muaz8172/hydro/docs/pdf/04_System_Diagram_and_Flowchart.pdf

1 · ARCHITECTURE

# Block diagram

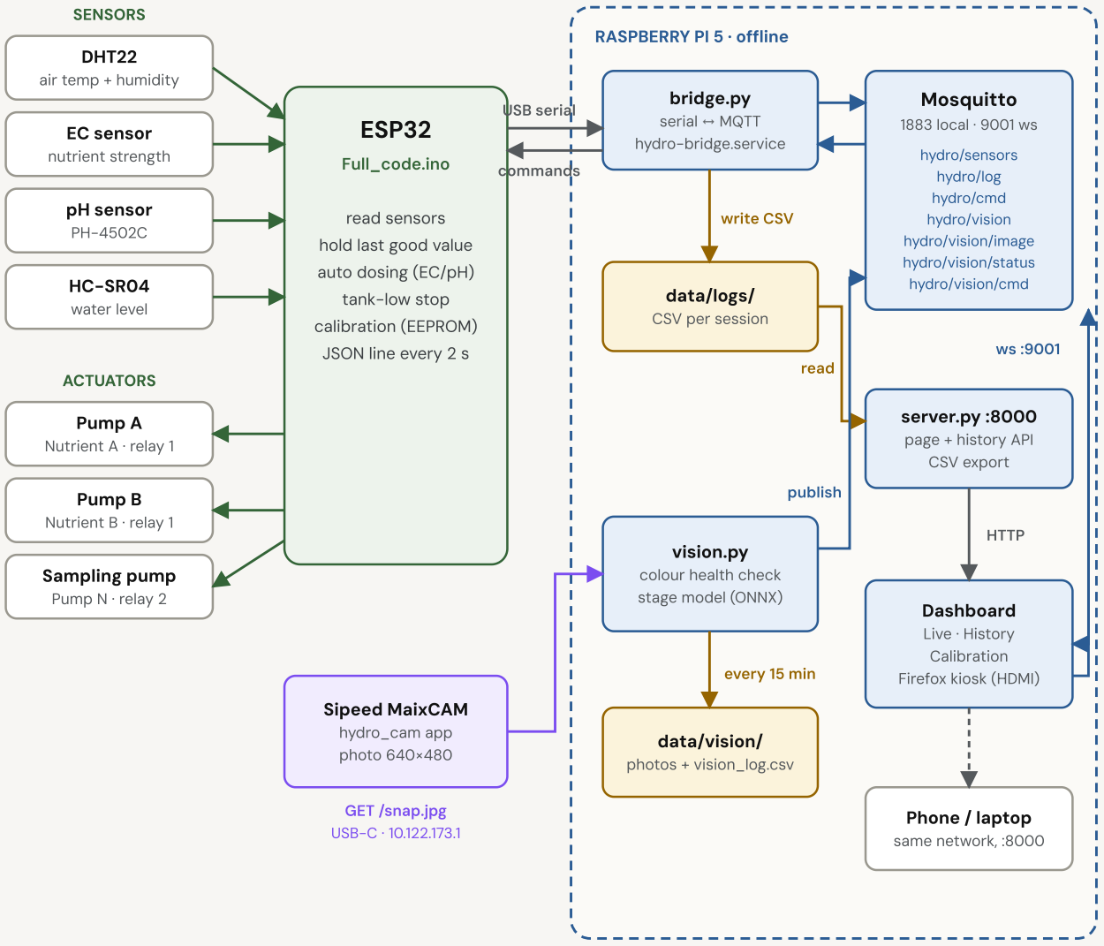
[picture p11: figure]
SENSORS; DHT22; air temp + humidity; EC sensor; nutrient strength; pH sensor; water level; ACTUATORS; Pump A; Nutrient A · relay 1; Pump B; Nutrient B · relay 1; Sampling pump; Pump N · relay 2; ESP32; Full_code.ino; read sensors; hold last good value; auto dosing (EC/pH); tank-low stop; calibration (EEPROM); JSON line every 2 s; Sipeed MaixCAM; hydro_cam app; photo 640×480; RASPBERRY PI 5 · offline; bridge.py; serial ↔ MQTT; hydro-bridge.service; Mosquitto; 1883 local · 9001 ws; hydro/sensors; hydro/log; hydro/cmd; hydro/vision; hydro/vision/image; hydro/vision/status; hydro/vision/cmd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

sensor / relay wiring | USB serial (JSON every 2 s) | MQTT | files on the Pi

camera (USB-C network)

In short: the ESP32 is the only part that touches the hardware and it keeps dosing and protecting the pumps even if the Pi is

off. The Pi adds memory (CSV logs), eyes (camera + AI) and a screen (dashboard). All links are local: a USB cable to the ESP32,

USB-C to the camera, and MQTT on the Pi itself.

HYDR O · INN OVAT I O N 202 6 · D O C U M ENT 4 O F 5

# System Diagram & Flowchart

How data moves from the sensors through the ESP32, the USB cable and the MQTT broker

to the logs, the camera AI and the dashboard, and how the firmware decides when to run

the pumps.

04

Hydro · 04 System Diagram & Flowchart | 1

2 · MESSAGING

# MQTT topics

Mosquitto runs on the Pi. Programs on the Pi use port 1883 (localhost only); the dashboard

in the browser uses the WebSocket listener on port 9001.

Topic | Published by | Read by | Content
hydro/sensors | bridge.py | Dashboard | One JSON reading every 2 s (+ log_id , row )
hydro/log | bridge.py | Dashboard | ESP32 text messages (calibration replies, warnings)
hydro/cmd | Dashboard, mosquitto_pub | bridge.py → ESP32 | Commands: status , enterec , ph7 , pumpauto , …
hydro/vision | vision.py | Dashboard | Health, canopy, yellowing, stage, confidence, size (JSON)
hydro/vision/image | vision.py | Dashboard | Latest photo as JPEG bytes (retained)
hydro/vision/status | vision.py | Dashboard | online or offline: <reason>
hydro/vision/cmd | Dashboard | vision.py | snap = save a photo now

### Path of one sensor reading

### Path of a command (e.g. calibration)

# Services on the Pi (start-up order)

Service | Starts when | Runs
mosquitto | Boot | MQTT broker (1883 local, 9001 websocket)
hydro-bridge | ESP32 plugged in (udev → /dev/esp32 ); stops when unplugged | backend/bridge.py
hydro-vision | Boot | backend/vision.py , photo every 10 s
hydro-dashboard | Boot | backend/server.py on port 8000
hydro-kiosk (user) | Desktop log-in | Firefox full screen on the HDMI monitor,
| | screen never blanks

Everything runs offline: the dashboard's libraries ( mqtt.js , uPlot) and fonts are stored in frontend/vendor/ . If

the browser cannot reach port 9001, the camera photo still updates over HTTP from frontend/live/ .

Hydro · 04 System Diagram & Flowchart | MQTT topics and data paths

# ESP32 firmware logic

### Main loop

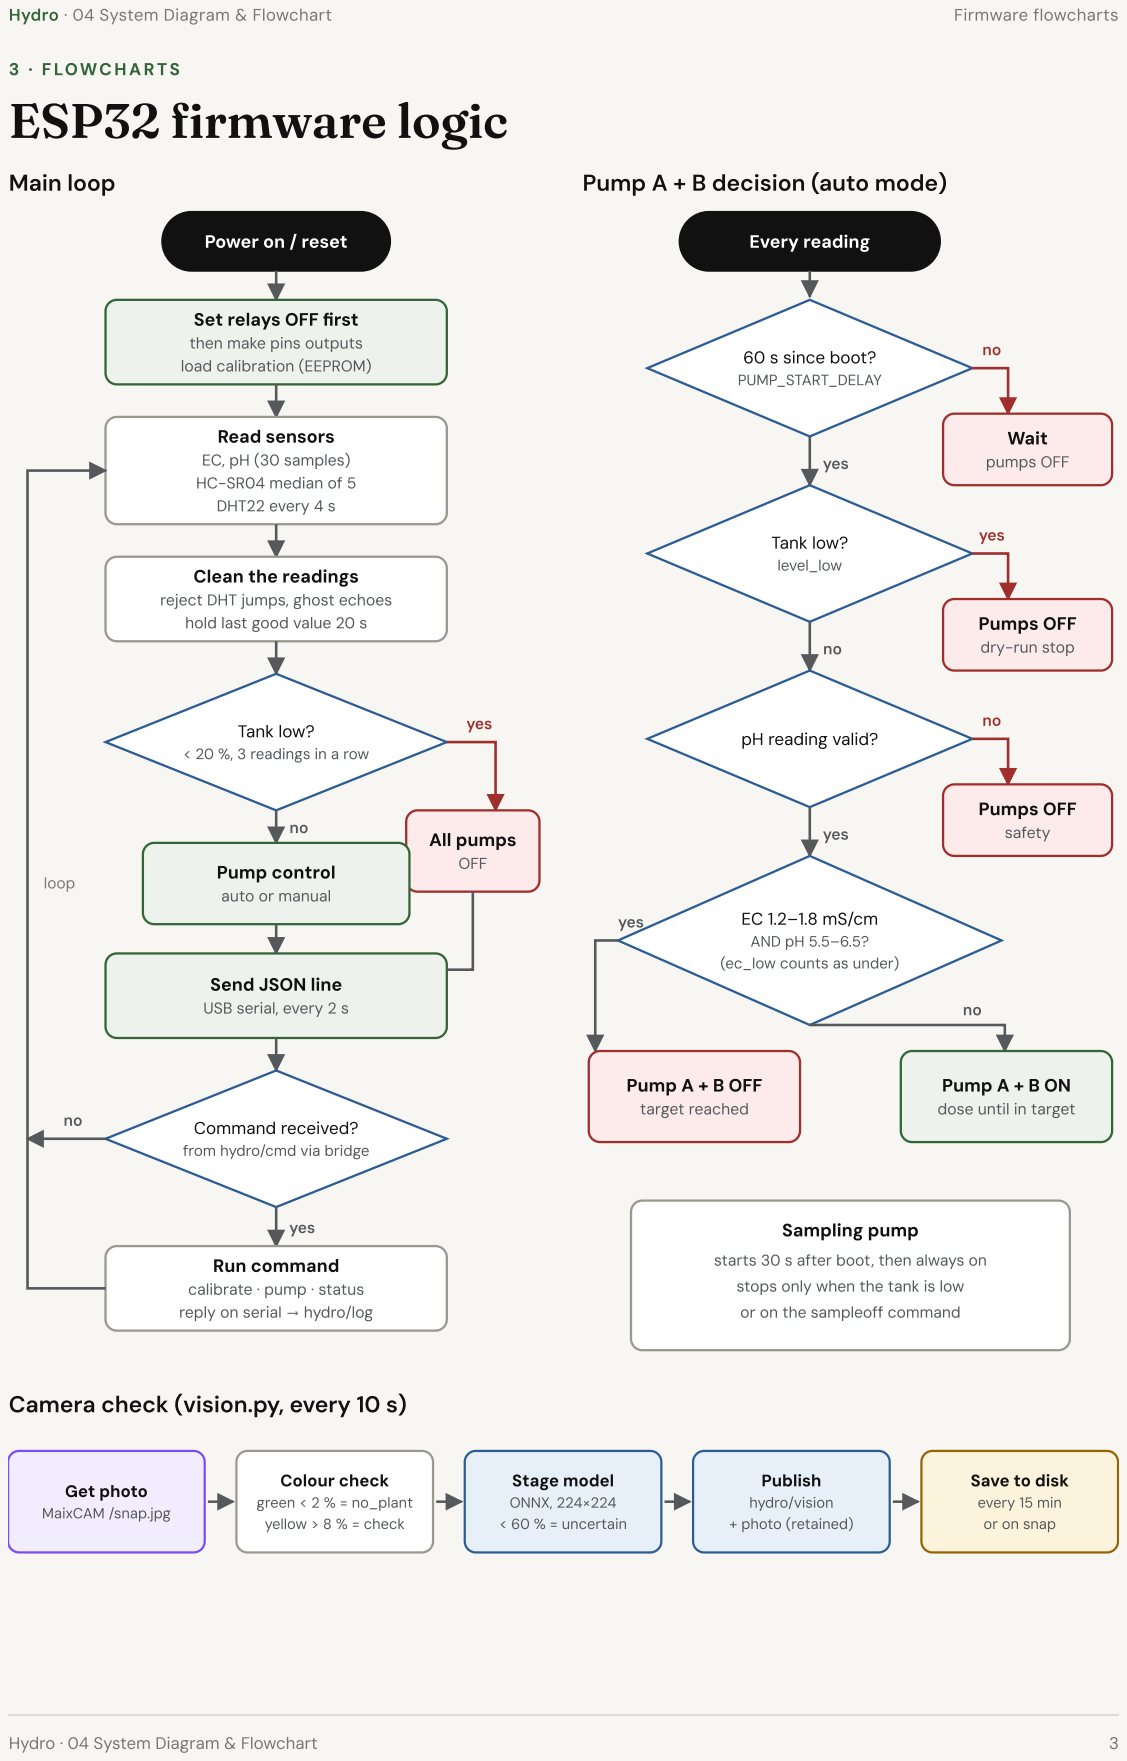
[picture p12: page 3]
3 · FLOWCHARTS; Read sensors; DHT22 every 4 s; Tank low?; yes; All pumps; OFF; Pump control; Command received?; Run command; loop; Every reading; 60 s since boot?; PUMP_START_DELAY; Wait; pumps OFF; level_low; Pumps OFF; dry-run stop; safety; Pump A + B OFF; target reached; Pump A + B ON; Sampling pump; Get photo; Colour check; green < 2 % = no_plant; yellow > 8 % = check; Stage model; ONNX, 224×224; < 60 % = uncertain; Publish; hydro/vision; + photo (retained); every 15 min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

Pump A + B decision (auto mode)

Power on / reset

Set relays OFF first

then make pins outputs

load calibration (EEPROM)

EC, pH (30 samples)

HC-SR04 median of 5

Clean the readings

reject DHT jumps, ghost echoes

hold last good value 20 s

pH reading valid?

< 20 %, 3 readings in a row

auto or manual

AND pH 5.5–6.5?
(ec_low counts as under)

Send JSON line

USB serial, every 2 s

dose until in target

from hydro/cmd via bridge

starts 30 s after boot, then always on

stops only when the tank is low

calibrate · pump · status
reply on serial → hydro/log

or on the sampleoff command

Camera check (vision.py, every 10 s)

Save to disk

MaixCAM /snap.jpg

or on snap
