muaz8172/hydro/backend/models/stage_training.png

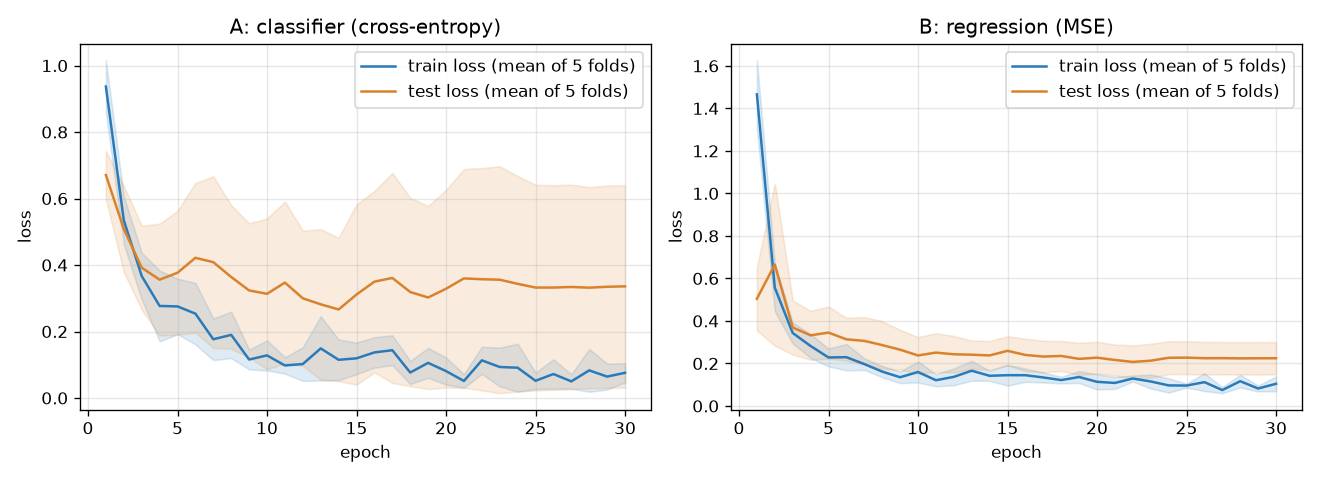
backend/models/stage_training.png
