muaz8172/hydro/dataset/lettuce_224/matured/matured_004.jpg

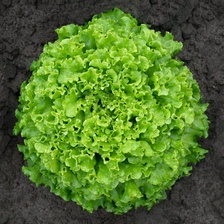
dataset/lettuce_224/matured/matured_004.jpg
