muaz8172/hydro/dataset/lettuce_224/matured/matured_005.jpg

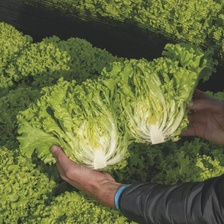
dataset/lettuce_224/matured/matured_005.jpg
