muaz8172/hydro/dataset/lettuce_224/matured/matured_009.jpg

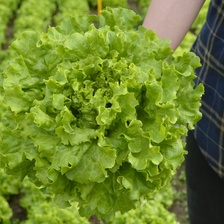
dataset/lettuce_224/matured/matured_009.jpg
