muaz8172/hydro/dataset/lettuce_224/matured/matured_011.jpg

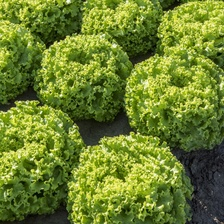
dataset/lettuce_224/matured/matured_011.jpg
