muaz8172/hydro/dataset/lettuce_224/matured/matured_013.jpg

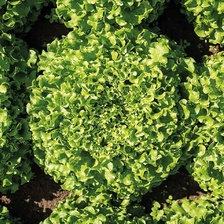
dataset/lettuce_224/matured/matured_013.jpg
