muaz8172/hydro/dataset/lettuce_224/matured/matured_015.jpg

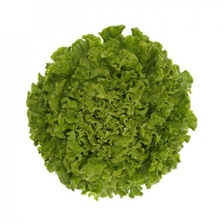
dataset/lettuce_224/matured/matured_015.jpg
