muaz8172/hydro/dataset/lettuce_224/matured/matured_016.jpg

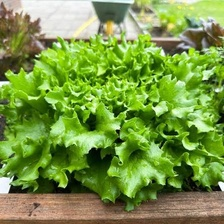
dataset/lettuce_224/matured/matured_016.jpg
