muaz8172/hydro/dataset/lettuce_224/matured/matured_023.jpg

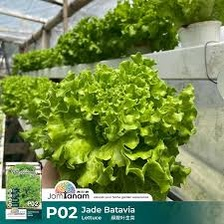
dataset/lettuce_224/matured/matured_023.jpg
