muaz8172/hydro/dataset/lettuce_224/matured/matured_024.jpg

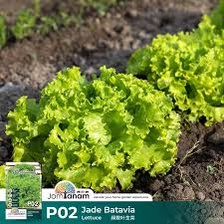
dataset/lettuce_224/matured/matured_024.jpg
