muaz8172/hydro/dataset/lettuce_224/matured/matured_025.jpg

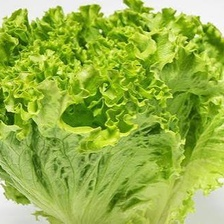
dataset/lettuce_224/matured/matured_025.jpg
