muaz8172/hydro/dataset/lettuce_224/matured/matured_026.jpg

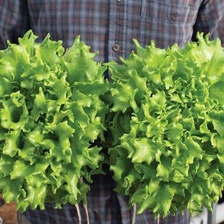
dataset/lettuce_224/matured/matured_026.jpg
