muaz8172/hydro/dataset/lettuce_224/matured/matured_027.jpg

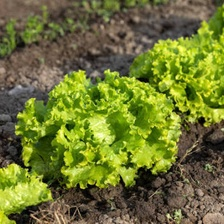
dataset/lettuce_224/matured/matured_027.jpg
