muaz8172/hydro/dataset/lettuce_224/seedling/seedling_005.jpg

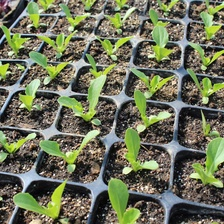
dataset/lettuce_224/seedling/seedling_005.jpg
