muaz8172/hydro/dataset/lettuce_224/seedling/seedling_006.jpg

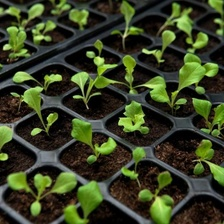
dataset/lettuce_224/seedling/seedling_006.jpg
