muaz8172/hydro/dataset/lettuce_224/seedling/seedling_009.jpg

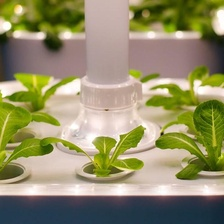
dataset/lettuce_224/seedling/seedling_009.jpg
