muaz8172/hydro/dataset/lettuce_224/seedling/seedling_015.jpg

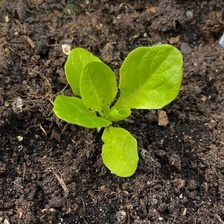
dataset/lettuce_224/seedling/seedling_015.jpg
