muaz8172/hydro/dataset/lettuce_224/seedling/seedling_016.jpg

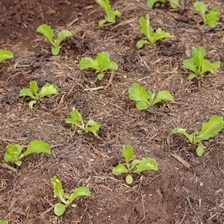
dataset/lettuce_224/seedling/seedling_016.jpg
