muaz8172/hydro/dataset/lettuce_224/seedling/seedling_018.jpg

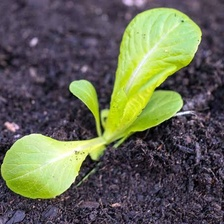
dataset/lettuce_224/seedling/seedling_018.jpg
