muaz8172/hydro/dataset/lettuce_224/seedling/seedling_019.jpg

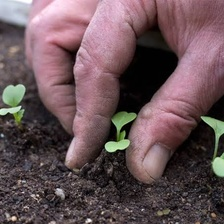
dataset/lettuce_224/seedling/seedling_019.jpg
