muaz8172/hydro/dataset/lettuce_224/seedling/seedling_021.jpg

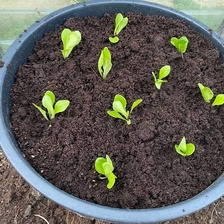
dataset/lettuce_224/seedling/seedling_021.jpg
