muaz8172/hydro/dataset/lettuce_224/seedling/seedling_027.jpg

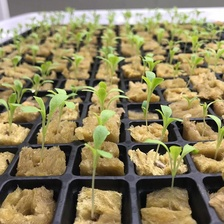
dataset/lettuce_224/seedling/seedling_027.jpg
