muaz8172/hydro/dataset/lettuce_224/seedling/seedling_029.jpg

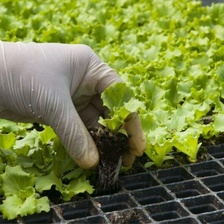
dataset/lettuce_224/seedling/seedling_029.jpg
