muaz8172/hydro/dataset/lettuce_224/vegetative/vegetative_008.jpg

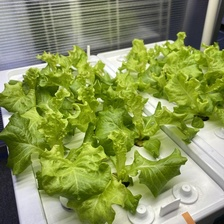
dataset/lettuce_224/vegetative/vegetative_008.jpg
