muaz8172/hydro/dataset/lettuce_224/vegetative/vegetative_009.jpg

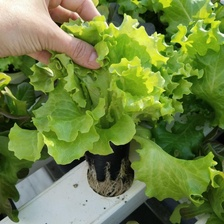
dataset/lettuce_224/vegetative/vegetative_009.jpg
