muaz8172/hydro/dataset/lettuce_224/vegetative/vegetative_010.jpg

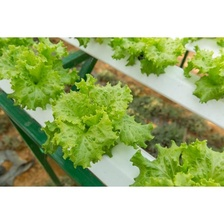
dataset/lettuce_224/vegetative/vegetative_010.jpg
