muaz8172/hydro/dataset/lettuce_224/vegetative/vegetative_013.jpg

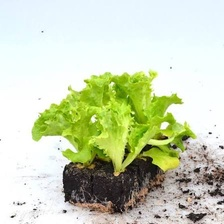
dataset/lettuce_224/vegetative/vegetative_013.jpg
