muaz8172/hydro/dataset/lettuce_224/vegetative/vegetative_015.jpg

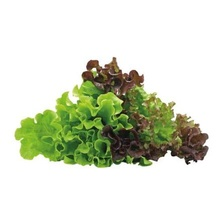
dataset/lettuce_224/vegetative/vegetative_015.jpg
