muaz8172/hydro/dataset/lettuce_224/vegetative/vegetative_016.jpg

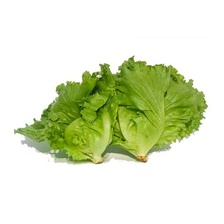
dataset/lettuce_224/vegetative/vegetative_016.jpg
