muaz8172/hydro/dataset/lettuce_224/vegetative/vegetative_020.jpg

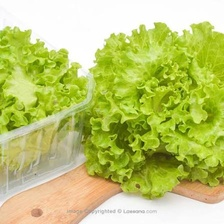
dataset/lettuce_224/vegetative/vegetative_020.jpg
