muaz8172/hydro/dataset/lettuce_224/vegetative/vegetative_021.jpg

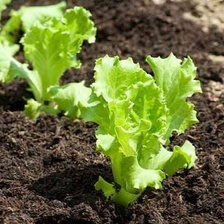
dataset/lettuce_224/vegetative/vegetative_021.jpg
