muaz8172/hydro/dataset/lettuce_224/vegetative/vegetative_027.jpg

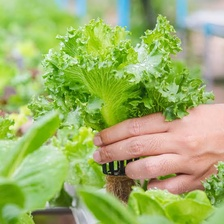
dataset/lettuce_224/vegetative/vegetative_027.jpg
