muaz8172/hydro/dataset/lettuce_growth_stages/matured/matured_006.jpg

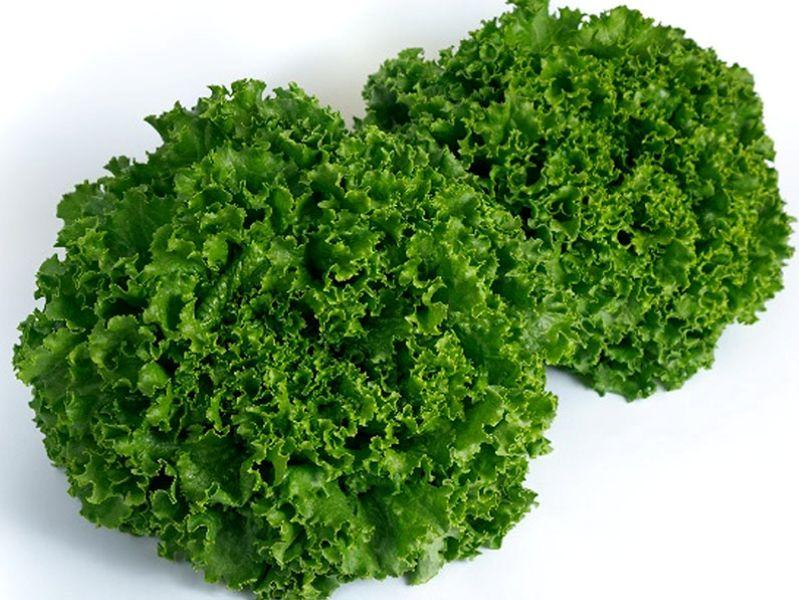
dataset/lettuce_growth_stages/matured/matured_006.jpg
