muaz8172/hydro/dataset/lettuce_growth_stages/matured/matured_025.jpg

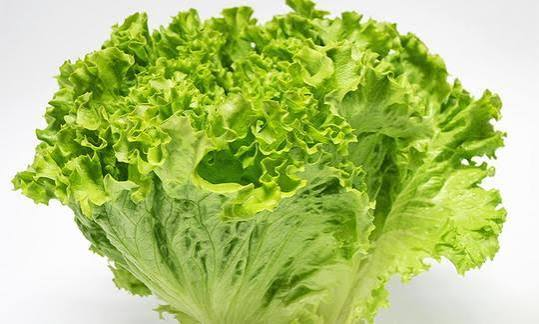
dataset/lettuce_growth_stages/matured/matured_025.jpg
