muaz8172/hydro/dataset/lettuce_growth_stages/matured/matured_028.jpg

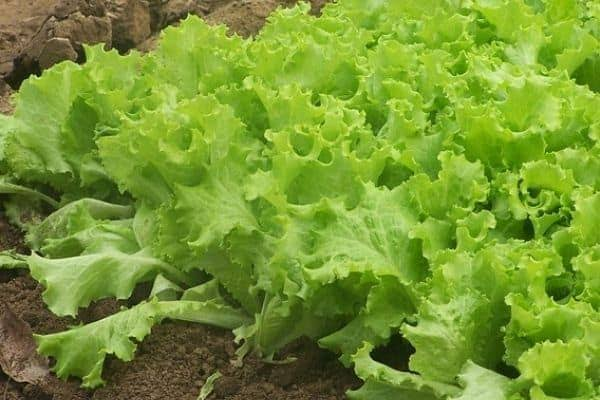
dataset/lettuce_growth_stages/matured/matured_028.jpg
