muaz8172/hydro/dataset/lettuce_growth_stages/matured/matured_029.jpg

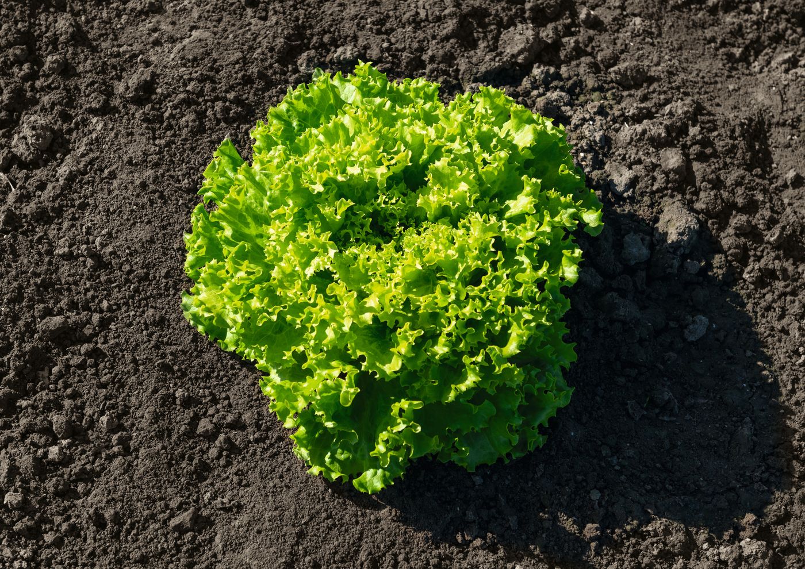
dataset/lettuce_growth_stages/matured/matured_029.jpg
