muaz8172/hydro/dataset/lettuce_growth_stages/seedling/seedling_005.jpg

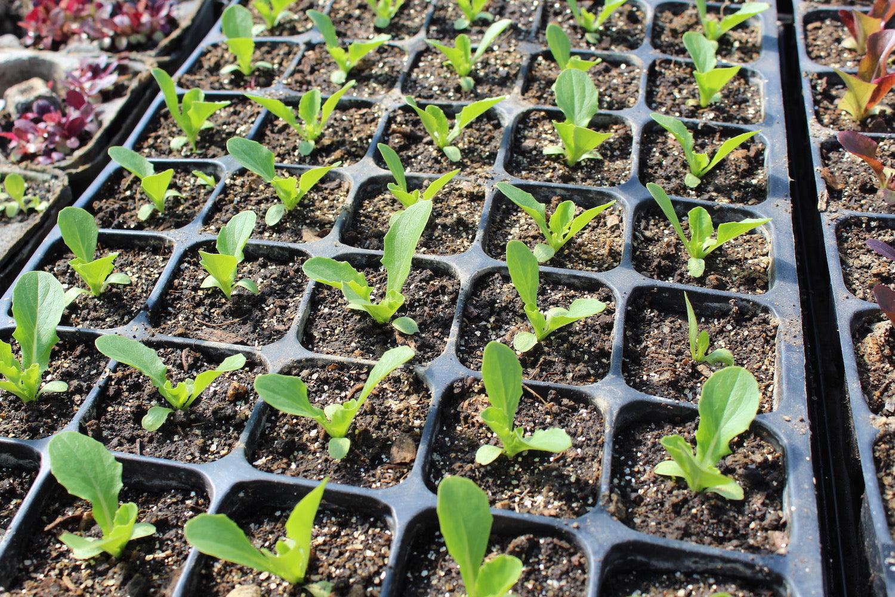
dataset/lettuce_growth_stages/seedling/seedling_005.jpg
