muaz8172/hydro/dataset/lettuce_growth_stages/seedling/seedling_019.jpg

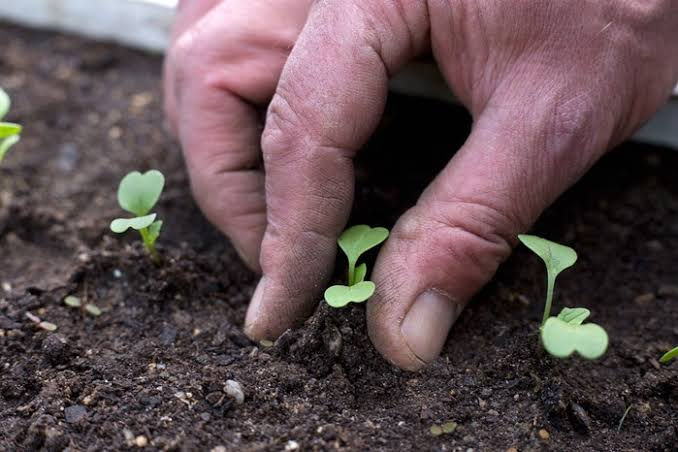
dataset/lettuce_growth_stages/seedling/seedling_019.jpg
