muaz8172/hydro/dataset/lettuce_growth_stages/vegetative/vegetative_002.jpg

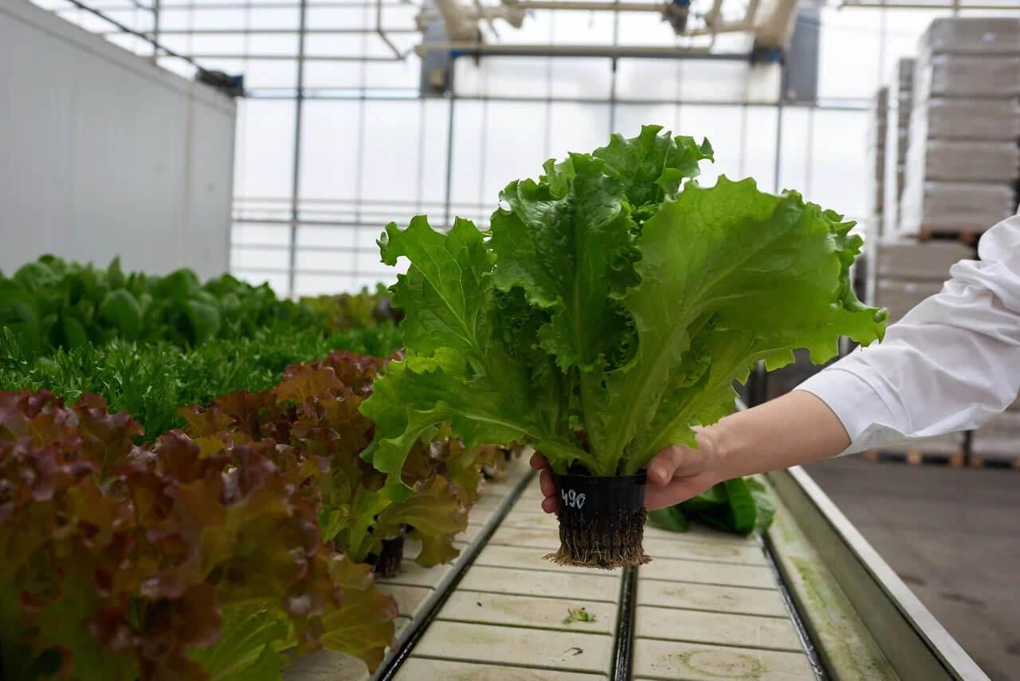
dataset/lettuce_growth_stages/vegetative/vegetative_002.jpg
