muaz8172/hydro/dataset/lettuce_growth_stages/vegetative/vegetative_011.jpg

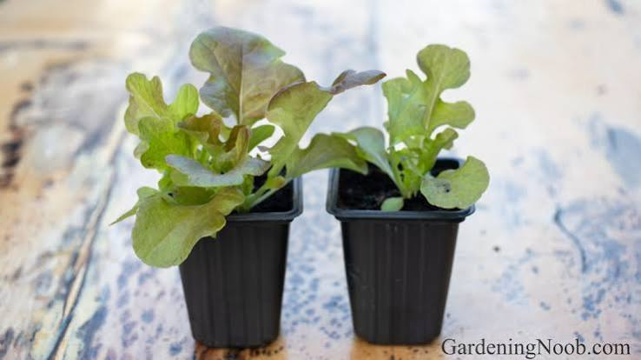
dataset/lettuce_growth_stages/vegetative/vegetative_011.jpg
