muaz8172/hydro/dataset/lettuce_growth_stages/vegetative/vegetative_020.jpg

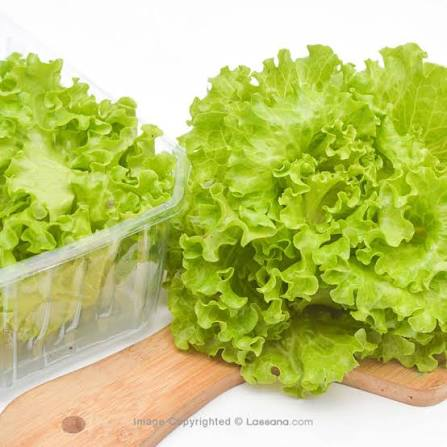
dataset/lettuce_growth_stages/vegetative/vegetative_020.jpg
