muaz8172/hydro/dataset/lettuce_growth_stages/vegetative/vegetative_022.jpg

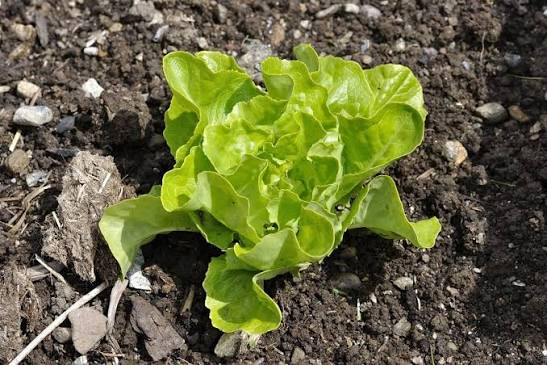
dataset/lettuce_growth_stages/vegetative/vegetative_022.jpg
