muaz8172/hydro/dataset/lettuce_growth_stages/vegetative/vegetative_025.jpg

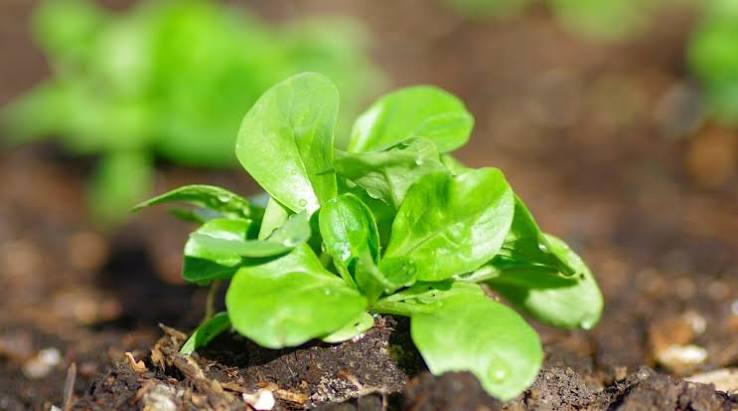
dataset/lettuce_growth_stages/vegetative/vegetative_025.jpg
