muaz8172/hydro/dataset/lettuce_growth_stages/vegetative/vegetative_026.jpg

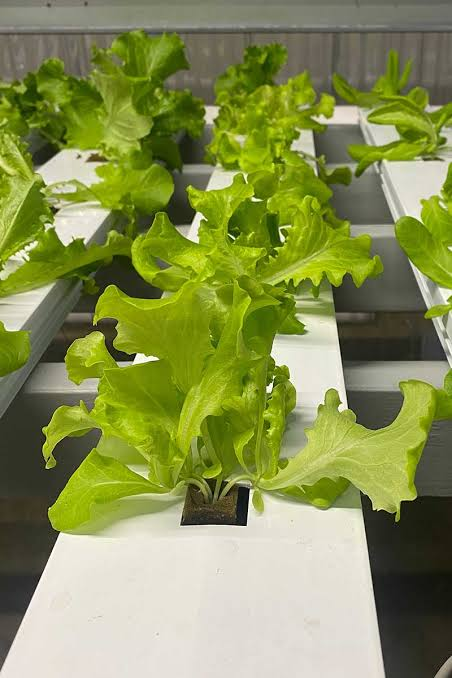
dataset/lettuce_growth_stages/vegetative/vegetative_026.jpg
