muaz8172/hydro/dataset/lettuce_growth_stages/vegetative/vegetative_028.jpg

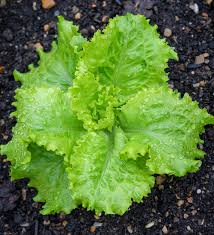
dataset/lettuce_growth_stages/vegetative/vegetative_028.jpg
