muaz8172/hydro/docs/pdf/screenshots/dashboard_graphs.jpg

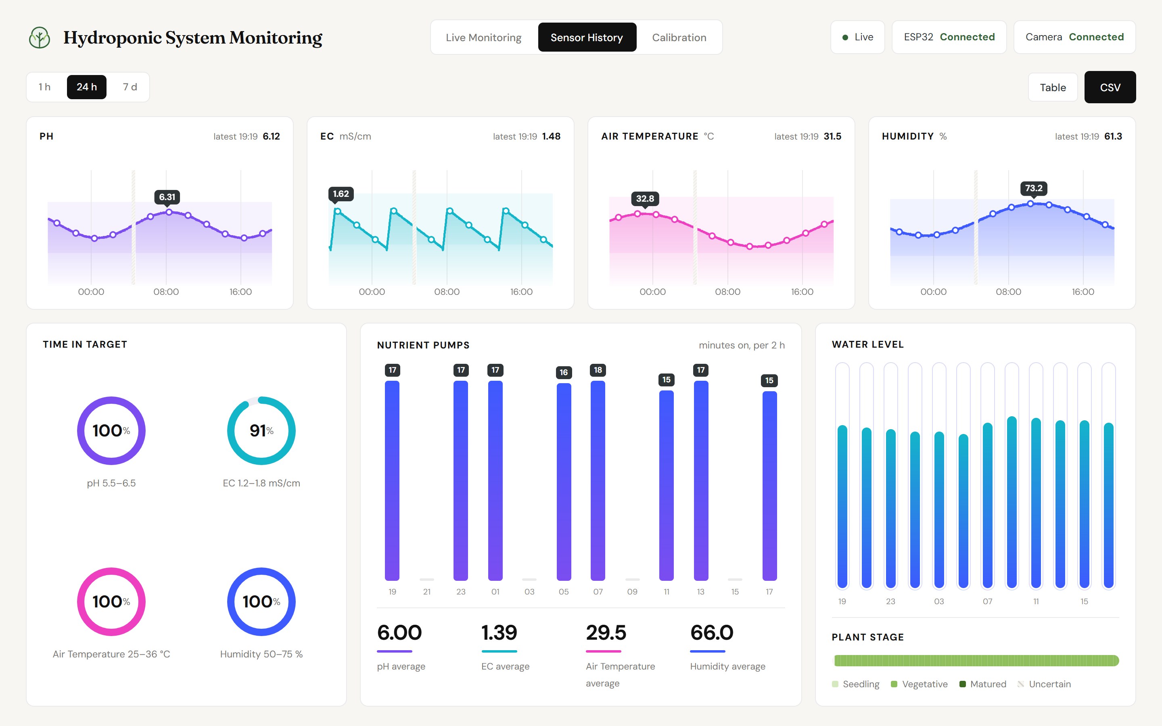
docs/pdf/screenshots/dashboard_graphs.jpg
