muaz8172/hydro/docs/pdf/screenshots/dashboard_calibration.jpg

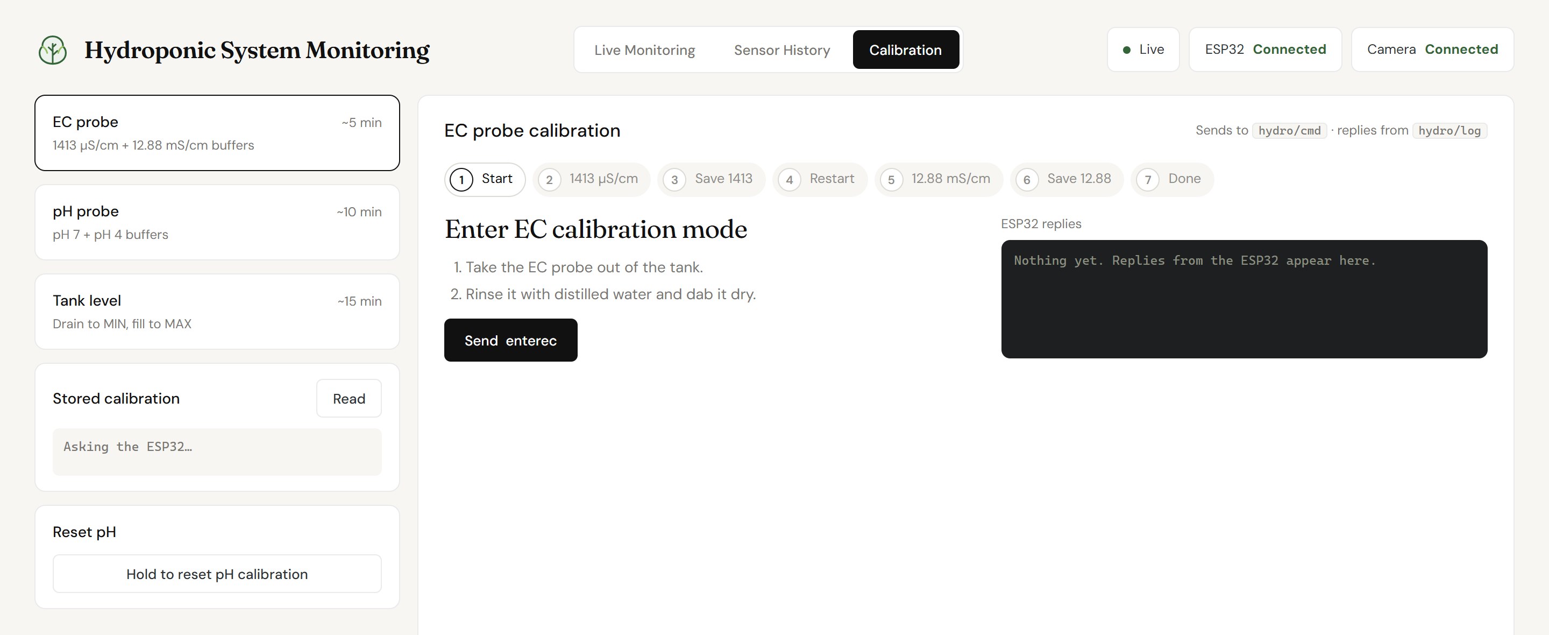
docs/pdf/screenshots/dashboard_calibration.jpg
