muaz8172/hydro/(commit log)

2026-09-23 Initial commit: ESP32 firmware, serial bridge, README
2026-09-23 Expand README with full system docs, wiring, calibration, and troubleshooting
2026-09-23 Add sensor prototyping files, circuit diagram, and reference PDFs
2026-09-23 Add relay test sketch and HC-SR04 tank level to full firmware
    - Relay_Test: 2-channel relay test (GPIO25/26) with auto and serial manual modes
    - Full_code: add HC-SR04 ultrasonic tank level (level, level_pct, level_low,
    dist_cm) with tankempty/tankfull calibration stored in EEPROM
2026-09-23 Add Pump A/B relay control to firmware and document relay test
    - Full_code: Pump A (GPIO25) and Pump B (GPIO26) run only while EC and pH
    are both in range (dummy ranges for now); manual pump commands; pump
    state added to JSON output
    - README: relay test method and result, wiring, roadmap
2026-09-23 Stop pumps when tank level is low
    Dry-run protection: when the tank is calibrated and level_low is true,
    Pump A and Pump B are forced OFF in both auto and manual mode, and
    manual pump-on commands are blocked until the tank is refilled.
2026-09-23 Document tank low pump stop in README
2026-09-23 Document HC-SR04 ultrasonic wiring and tank calibration in README
    - Wiring: TRIG GPIO32, ECHO GPIO33 via 1k/2k divider, 5V
    - JSON example and fields: level, level_pct, level_low, dist_cm, pump state
    - Tank calibration steps (tankempty / tankfull / tankreset)
2026-09-23 Pumps run until EC and pH reach target, then stop
    Previously Pump A/B ran only while EC and pH were in range. Now they run
    while either is off target and stop once both are in range. ec_low counts
    as below target; an invalid pH reading still turns the pumps off.
2026-09-23 Document pump auto control (run until EC and pH reach target) in README
2026-09-23 Set pump targets: EC 1.2-1.8 mS/cm, pH 5.5-6.5
    Replace the dummy ranges. Pump A/B run (auto) while EC or pH is lower or
    higher than the target and stop once both are inside.
    [Full_code.ino]
2026-09-23 Add always-on sampling pump on GPIO27 (1-channel relay)
    - Sampling pump runs all the time from boot; sampleoff / sampleon commands
    - Stopped by the tank-low dry-run protection like Pump A/B
    - pump_sample added to JSON and status; README wiring and docs updated
2026-09-23 Log each ESP32 session to CSV, including pump state
    - bridge.py starts a new data/logs/log_NNNN_<date>_<time>.csv per connection
    and adds log_id/row to hydro/sensors messages
    - Log pump_a, pump_b, pump_auto, pump_sample columns (1/0)
    - Open the serial port exclusively; stop ModemManager probing the ESP32
    - Ignore data/ and document the log format in README
2026-09-23 Add dashboard design plan
    Covers live readings, pump status (A/B auto to EC/pH target, always-on
    sampling pump, tank-low lock), history from session CSVs, calibration
    wizards and the later plant-vision phase.
2026-09-23 Add MaixCAM plant camera with leaf colour health check
    - maixcam/hydro_cam: MaixPy app on the camera; live preview on its screen,
    serves /snap.jpg to the Pi over the USB network link only
    - vision.py: live photo every 10 s published to hydro/vision (+ /image,
    /status), saved to data/vision + CSV every 15 min or on "snap"
    - Health = yellow/brown share of leaf area; no_plant when <2% green
    - hydro-vision.service to run it at boot
    Claude-Session: https://claude.ai/code/session_01VbmRZ9AMfjE9X4NCmHSGCY
    [vision.py]
2026-09-23 Add first live dashboard page (camera photo, sensors, pumps)
    Static page served on port 8000; live data over Mosquitto websockets
    with a vendored mqtt.js, so it works offline. Shows the latest MaixCAM
    photo and health result, sensor tiles with target bands, pump states and
    mode. Document camera and dashboard setup in README Part 5.
    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
2026-09-23 Dashboard: keep the camera photo updating when MQTT is blocked
    vision.py also writes data/vision/live/latest.jpg + latest.json on every
    capture; the page polls them over HTTP whenever the MQTT websocket is
    down or quiet, and says so in the header.
    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
2026-09-23 Add system guide PDF: how it works, progress, and how to run
    11-page guide covering the architecture, wiring, sensors and pump
    control, CSV logging, the MaixCAM camera and dashboard, what has been
    built so far, setup and daily commands, calibration, troubleshooting,
    and known safety issues. Linked from the README.
    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
2026-09-24 Add lettuce growth-stage image dataset (41 photos)
    dataset/lettuce_growth_stages/ holds 18 seedling, 6 vegetative and 17
    matured lettuce photos, one folder per stage (the folder is the label).
    labels.csv lists each photo's stage, format, size and original file
    name. Linked from the README (Part 5, repository structure, roadmap).
    [labels.csv]
2026-09-24 System guide: add the growth-stage image dataset
    New section 3.6 (Plant image dataset) with the stage counts and notes on
    formats and class balance. Progress table, commit history and roadmap
    updated; status date is now 24 September 2026.
2026-09-24 Add 224x224 JPEG copy of the lettuce dataset with size labels
    All 41 growth-stage photos converted to 224x224 JPEG (AVIF/WEBP included),
    centre-cropped. labels.csv adds size: seedling=small, vegetative=medium,
    matured=large. Originals are unchanged.
    Claude-Session: https://claude.ai/code/session_01RTboVpBoKgstLJiuW5zsfD
    [labels.csv]
2026-09-24 Add growth-stage model, Graphs and Calibration tabs, history server
    - train/train_stage.py: MobileNetV3-Small on dataset/lettuce_224, 5-fold CV,
    report with accuracy and MAE/MSE/RMSE/MAPE vs baselines, ONNX export.
    First result: 90% test accuracy, MAE 0.10 (vegetative recall 50%).
    - vision.py: runs models/stage.onnx on each photo with a plant in view;
    publishes stage, stage_conf and size (size follows stage), logs them,
    upgrades the old vision_log.csv. Runs from .venv (onnxruntime).
    - dashboard/server.py: serves the page plus /api/history,
    /api/actuators/history, /api/vision/history and /api/export.csv from
    the session CSVs (standard library only).
    - dashboard: Overview gains sta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
    [stage_predictions.csv]
2026-09-24 Reorganise repo into frontend/ and backend/
    - frontend/: dashboard page (index.html, vendor/, live link)
    - backend/: bridge.py, vision.py, server.py (was dashboard/server.py),
    models/, train/, systemd/*.service, mosquitto/, udev/
    - Paths in the code now resolve from backend/ to the repo root, so data/
    (logs, photos) stays where it was. Service files point to backend/.
    - README and dashboard plan updated for the new layout.
    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
    [stage_predictions.csv]
2026-09-24 Move ESP32 sketches into firmware/
    Full_code (main firmware), Relay_Test, DHT22, EC_Sensor, PH_Sensor and
    esp32_hydroponic_sensors now live under firmware/. Each sketch keeps its
    own folder, as the Arduino IDE needs. README paths updated (it still
    pointed at an old esp32/hydro_esp32/ folder).
    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
2026-09-24 Set air temperature target to 25-36 C
    Full_code.ino gets TEMP_MIN/TEMP_MAX (25.0/36.0 C), shows them in
    `status` and reports "temp_ok" in the JSON (null without a DHT22
    reading). Nothing on the ESP32 acts on it. The dashboard's air temp band
    changes from 18-26 to 25-36 C.
    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
2026-09-24 Replace 1-channel relay with a second 2-channel relay
    Sampling pump moves to relay 2 IN1 (still GPIO27); relay 2 IN2 is spare.
    Both relays share RELAY_ACTIVE_LOW, so SAMPLE_ACTIVE_LOW is removed.
    [Full_code.ino]
2026-09-28 Replace lettuce dataset with 90 new photos (30 per stage)
    Rebuild dataset/lettuce_growth_stages/ and the 224x224 copy in
    dataset/lettuce_224/ from the new seedling, vegetative and mature
    photos, regenerate both labels.csv files, and update photo counts
    in the docs.
    [labels.csv]
2026-09-28 Retrain growth-stage model on 88 photos; system guide v3
    Remove vegetative_012.jpg / matured_022.jpg (the same photo with two
    labels) from both dataset copies, leaving 88 photos (30/29/29), all
    224x224 in lettuce_224/. Raise the vegetative-recall pass criterion
    to >= 70 %.
    Retrained model (5-fold CV): classifier chosen, 86 % test accuracy,
    MAE 0.16, vegetative recall 79 %; all pass criteria met. On the 48
    photos the old model never saw it scored 60 % (vegetative 29 %); the
    new CV predictions score 81 % (vegetative 79 %). Old model kept as
    backend/models/stage_old.onnx.
    System guide v3 builds on v2 (branch claude/exciting-bohr-dnd91c) and
    is now generated by docs/guide/build_guide.py.
    Co-A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
    [labels.csv, stage_predictions.csv]
2026-09-28 Ignore out-of-range pH readings in history and cap graph axes
    server.py drops pH values outside 0-14 (probe fault, e.g. 19.71) from
    the history averages. The Graphs tab still widens the y-axis to fit the
    data, but never past a per-sensor limit, so one wild reading can't
    flatten the chart.
2026-09-29 Redesign dashboard in a minimalist style
    - Header: "Hydroponic System Monitoring" with a lettuce icon; tabs renamed
    Live Monitoring / Sensor History / Calibration; separate Live, ESP32 and
    Camera cards with coloured Connected/Disconnected words
    - Warm monochrome palette, DM Sans + Fraunces (vendored woff2, works offline)
    - Live Monitoring: square camera frame showing the same centre crop the
    stage model sees; compact sensor tiles with dot or LOW/HIGH/DRIFT tag,
    raw values in tooltips; pump rows; Plant vision card (canopy vs yesterday,
    yellowing vs the 8 %/20 % thresholds, green index); small 24 h graph of
    the selected tile
    - Sensor History: smooth spline lines with a soft fill, o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
    [server.py]
2026-09-29 Charts: leave empty time before/after the data blank instead of hatched
    Only gaps between readings are hatched (more faintly). Time before the first
    reading or after the last gets a small "no data before/since" note, and a
    sensor with no readings shows "No readings in this range".
    Claude-Session: https://claude.ai/code/session_01D34GzjJ4SWrqMJFoHJY7EH
2026-09-29 Sensor History: infographic charts and a paged table
    - Area charts with stronger fill, white dot markers and a value tag on the
    peak; vivid per-sensor colours (pH purple, EC teal, air magenta,
    humidity blue); y axis dropped, hover readouts kept
    - New summary row: time-in-target ring gauges, nutrient pump minutes per
    slot as tagged bars, per-sensor averages, water level capsule bars and
    the plant stage timeline (pump lanes replaced by the bar chart)
    - Table shows every reading in the range, one page at a time (rows sized
    to fit the screen), with page numbers and prev/next instead of a
    scrollbar and the old 400-row cap
    Claude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
2026-09-29 System guide: describe the new Sensor History tab
    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
2026-09-29 Feed live MQTT readings into the charts
    The charts only re-downloaded history every 10 s (1 h), 60 s (24 h) or
    120 s (7 d), and the overview graph every 60 s, so they lagged up to two
    minutes behind the tiles. Measured: ESP32 -> MQTT -> websocket delivery is
    about 0.4 s, so the lag was entirely these timers.
    Each reading from hydro/sensors is now added to the loaded history grid
    (same slots and filters as history() in server.py: pH outside 0-14 and EC
    at the sensor floor are blanked) and pump runs are extended, then the
    charts redraw. The timed reloads stay as a correction. A table page other
    than the first is left alone so rows don't move while reading.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
2026-09-29 Live Monitoring: animated water tank instead of the small graph
    The tank fills to level_pct from the ultrasonic sensor (smooth rise/fall,
    drifting waves, bubbles; still under prefers-reduced-motion), shows the
    20 % dry-run line, an OK/LOW/No reading tag, water height and distance to
    the surface. The Water tile is removed (the tank shows the same value);
    Pump mode now spans two columns. Tiles open Sensor History on click.
    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
2026-09-29 Calibration: judge EC steadiness by drift, block out-of-window captures
    The EC wizard needed the 10 s max-min swing under 1 % (6.7 mV at 670 mV),
    but the probe's normal noise is about ±14 mV: in 170 logged readings no
    10 s window ever passed, so Capture never enabled. Steadiness is now the
    difference between the mean of the last 10 s and the 10 s before, within
    2 % (min 5 mV); on the same log that passes 99 of 108 settled windows.
    Also stop a capture the ESP32 would reject: DFRobot_EC only accepts the
    1413 buffer at 148-311 mV and 12.88 at 1476-2755 mV (rawEC = mV / 164),
    and the wizard now says so instead of sending calec.
    Claude-Se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
2026-09-29 Firmware: read EC on 11 dB so its millivolts are not 3x too high
    readEcVoltage() set the EC pin to 0 dB but converted with
    analogReadMilliVolts(), whose calibration is built once for the global
    attenuation (11 dB by default). A 0 dB raw value converted as 11 dB comes
    out about 3x high: 1413 uS/cm buffer read ~680 mV (EC ~4.1) instead of
    ~230 mV, outside DFRobot_EC's 148-311 mV window, so calibration could
    never succeed. EC now stays on 11 dB like pH. Same fix in the EC_Sensor
    test sketch.
    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
    [EC_Sensor.ino, Full_code.ino]
2026-09-29 Calibration: save each EC buffer separately
    DFRobot_EC's exitec writes only the K of the buffer the probe is in at
    that moment. The wizard captured 1413 and 12.88 and then saved once with
    the probe in 12.88, so Khigh (1.094) was stored and Klow (1.07) was lost:
    status showed Klow=1.000. The EC wizard now runs enterec -> calec ->
    exitec per buffer, and each save step checks the probe is still in that
    buffer's window before sending exitec.
    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
2026-09-29 Firmware: commit EC calibration to flash on exitec
    On the ESP32, EEPROM.write() only changes the copy in RAM; nothing reaches
    flash until EEPROM.commit(). DFRobot_EC never committed, so EC K values
    were lost at the next reset: calibrated Klow=1.037 / Khigh=1.094 at 04:08,
    the ESP32 reset at 04:11 and read 246 mV as EC 1.50 (K=1.000). Opening the
    USB serial port resets the ESP32, so every bridge reconnect lost them.
    exitec now writes both K values and commits, in both DFRobot_EC.cpp copies
    (the header comment already claimed this patch existed; it did not).
    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
    [DFRobot_EC.cpp, Full_code.ino]
2026-09-29 Firmware: report whether EC calibration reaches flash
    After d9f4a28 a save stored Klow=1.123 / Khigh=1.119, but after unplugging
    and replugging the ESP32 reported 1.000 / 1.000. To find where it breaks:
    - exitec prints whether EEPROM.commit() succeeded
    - the 8 EC K bytes are read from flash at boot, before ec.begin() fills
    in defaults, and status prints them ("flash at boot: ..." or "empty")
    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
2026-09-29 Add ESP32 crash log from EC save (exitec) for decoding
    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
2026-09-29 Firmware: locate what corrupts the flash mutex (temporary probes)
    Decoded crash (core 3.3.12): EEPROM.commit() -> nvs_set_blob -> ... ->
    spi_flash_op_lock -> xQueueTakeMutexRecursive asserts because the flash
    op mutex has been overwritten. EEPROM.begin() reads flash fine at boot, so
    something in the running program corrupts it.
    After each loop() step a 4-byte flash read takes the same lock, and the
    step name is kept in RTC_NOINIT memory; after a panic reboot the ESP32
    prints "# CRASH after step: <name>". status also prints loop stack and
    heap headroom. To be removed once the cause is fixed.
    Claude-Session: https://claude.ai/code/sessi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
    [Full_code.ino]
2026-09-29 Firmware: do EC conversion and calibration without DFRobot_EC
    Crash hunt result (probes from 0802220): the flash mutex is intact at the
    start of loop() and corrupted right after handling an EC command. "calec"
    sent outside calibration mode - which only enters DFRobot_EC::calibration()
    and does nothing else - reproduces it; "pumpauto" does not. Every EC save
    then asserted in spi_flash_op_lock, so no calibration ever reached flash.
    The library is ~30 lines of maths, so it is replaced in Full_code.ino with
    the same behaviour: raw EC = mV / 164, K windows 0.5-1.5, buffer windows
    148-311 mV (1413) and 1476-2755 mV (12.88), range switch 2.0/2.5, and the
    same enterec/calec/exitec replies the dashb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
    [DFRobot_EC.cpp, DFRobot_EC.h, Full_code.ino]
2026-09-29 Firmware: remove the temporary crash probes
    The EC library replacement (b89f97e) fixed it: calec/enterec no longer
    crash, both saves reported "written to flash", and after unplugging and
    replugging the ESP32 booted with Klow=0.917 / Khigh=1.127 from flash.
    Keeps the "written to flash" and "flash at boot" messages.
    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
    [Full_code.ino]
2026-09-29 Docs: EC calibration is built into the firmware now
    README and system guide no longer point to the patched DFRobot_EC files,
    explain why the library was dropped, and describe the per-buffer save
    (enterec, calec, exitec for each buffer) with the accepted mV windows and
    the "written to flash" check. Guide commit history updated.
    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
    [build_guide.py]
2026-09-29 Bridge: start automatically when the ESP32 is plugged in
    - udev rule adds TAG+="systemd" and SYSTEMD_WANTS=hydro-bridge.service, so
    plugging the ESP32 in starts the bridge even if it had been stopped
    - when the bridge opens the port it resets the ESP32 through the board's
    auto-reset circuit (DTR low = normal boot, RTS pulse = EN), so it always
    starts its program; after a reboot it sat silent until EN was pressed
    - then it sends a newline to clear reset noise that garbled the first
    command ("unknown command: UUTT...CALEC")
    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
    [bridge.py]
2026-09-29 Bridge service runs only while the ESP32 is plugged in
    hydro-bridge.service is now BindsTo/WantedBy dev-esp32.device instead of
    WantedBy multi-user.target: plugging the ESP32 in (or booting with it
    attached) starts the bridge, unplugging it stops the bridge, and shutdown
    stops it as usual. Tested: plug -> started, opened /dev/esp32, reset the
    ESP32 within 3 s; unplug -> stopped at once. README install steps updated
    (disable the old boot link, then enable).
    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
2026-09-29 Firmware: start delay for the pumps after ESP32 boot
    The sampling pump waits 30 s and Pump A/B auto control waits 60 s after
    every ESP32 boot (Pi reboot, bridge restart or USB replug). Manual
    commands are not delayed. README and system guide updated.
    Claude-Session: https://claude.ai/code/session_01Lsq6hDexoirMdt9tretV5E
    [Full_code.ino, build_guide.py]
2026-09-29 Guide: bridge hot-plug, pump start delay, current status
    - 5.2: bridge is tied to the ESP32 device (disable the old boot link first)
    - 5.3 / troubleshooting: sampling pump starts after 30 s, Pump A/B after 60 s
    - header dots named as on the dashboard (Live, ESP32, Camera)
    - section 4: new work items and commits 27a3ecb, f8898e1, 4b692ae, aa305f1
    - current status from 29 Sep (log #0043, services running, probes still to check)
    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
2026-10-07 Remap Full_code ESP32 pins to new IO layout
    Pump In (Pump A) D18, Pump Out (Pump B) D19, Pump N (sampling) D21,
    DHT22 D12, HC-SR04 TRIG D33 / ECHO D32, EC D34, pH D35.
    Pump logic, serial commands and JSON keys unchanged. README wiring
    table updated to match.
    Claude-Session: https://claude.ai/code/session_017ubx24p4BDBrymsqpSRhbE
2026-10-07 Update test sketches, design plan and system guide to new pin layout
    Relay_Test: D18/D19. DHT22 test: D12. esp32_hydroponic_sensors: EC 34,
    pH 35, DHT 12, TRIG 33 / ECHO 32. Dashboard plan pump table renamed and
    moved to GPIO18/19/21. System guide v5 (7 Oct 2026): wiring tables, relay
    diagram, troubleshooting and status updated, GPIO12 strapping-pin note
    added; PDF rebuilt.
    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
2026-10-14 Firmware: move all pins to safe ESP32 GPIOs
    DHT22 -> GPIO4, EC -> GPIO32 (ADC1), pH -> GPIO33 (ADC1),
    HC-SR04 TRIG/ECHO -> GPIO16/17, relays stay on GPIO18/19/21.
    Drops GPIO12 (strapping pin) for the DHT22. Test sketches,
    README and system guide updated to match.
    Claude-Session: https://claude.ai/code/session_01MyuWnxSwrHx73V45zkraSU
2026-10-14 Firmware: built-in EC 1413 K of 0.79 from measured buffer reading
    1413 uS/cm buffer read 285 mV at 23.5 C, so K = 0.79 is used for the low
    range while flash holds no calibration. status now also prints the K in use.
    Guide updated.
2026-10-14 EC: accept this probe's 12.88 reading, recover wizard after ESP32 restart
    - Firmware: 12.88 buffer window from raw 6.0 (was 9.0), K allowed 0.5-2.0
    (was 1.5), built-in Khigh 1.55 from the measured ~1330 mV, and range
    switching judged on the low-range scale so it can't stick on high.
    - Dashboard: 12.88 steps accept 984-2755 mV; if the ESP32 restarts or
    answers Command Error mid-calibration, go back to the enterec step.
    [Full_code.ino]
2026-10-14 Firmware: pH as slope*V + offset from ph7/ph4 calibration, print formula
    Claude-Session: https://claude.ai/code/session_018a33Ux7a6pRNVCfNNDkvDg
2026-10-14 pH: defaults from this probe (pH7=3940mV, pH4=4677mV), wider cal limits, ADC-limit warning
    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
2026-10-15 Dashboard: Air Temperature tile reads Cold / Stable / Hot (25-36 C band)
    Claude-Session: https://claude.ai/code/session_01UiRYYSiYEZnA9aNAsPX34b
2026-10-15 Dashboard: Cold air temperature badge in blue
    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
2026-10-15 Fill sensor gaps: DHT22 every 4 s with jump reject, hold last good temp/hum/level 20 s, ignore ultrasonic ghost echoes, level_low needs 3 lows; dashboard greys held values
    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
2026-10-15 System guide version 6: sensor gap filling, pH/EC calibration updates, status as of 15 Oct, re-flash and SD card tips
2026-11-13 docs/pdf: five project PDFs (Introduction, ESP32 pins, Dataset, System diagram + flowchart, Dashboard overview) with dashboard screenshots; system guide moved into docs/pdf
    - HTML sources + render.py in docs/pdf/src (dashboard fonts and colours), rebuild with Playwright
    - Dashboard screenshots (Live Monitoring, Sensor History, Calibration) taken with simulated data
    - Hydro_System_Guide.pdf moved to docs/pdf/; build_guide.py and README links updated
    - README lists the new documents and the docs/ layout
2026-11-13 README: final short project overview (why, features, diagram, docs, quick start, status); details now live in docs/pdf
    - All project PDFs in docs/pdf (EC sensor guide and project paper moved from the repo root)
    - Setup, calibration, commands and troubleshooting are in docs/pdf/Hydro_System_Guide.pdf
    - Dataset README links to 03_Dataset.pdf instead of the old README section
